dmBots/DM-H65-1EC/README.md

# DM-H65-1EC

[中文](./README.zh.md) | EN

## Overview

This folder is the Chinese source of materials for DM-H65-1EC. Maintainers update the Chinese source folders only; Gitee preserves them, and GitHub publishing maps them to English paths.

## Source Mapping

| Chinese source folder | GitHub publish folder | Notes |
| --- | --- | --- |
| `说明书/` | `manual/` | manuals, datasheets, and usage notes |
| `2D图纸/` | `drawings/2d/` | 2D drawings, dimensions, and schematic materials |
| `3D模型/` | `models/3d/` | 3D models and mechanical files |
| `测试数据/` | `test-data/` | test data, performance curves, and validation materials |
| `版本说明/` | `release-notes/` | release notes and change records |

## Publishing Policy

- The source folder keeps Chinese paths for maintainers.
- Gitee uses Chinese paths and Chinese README by default.
- GitHub is generated with English paths and English README by the publish script.
- Do not maintain a second English source tree manually.
