dmBots/DM-H65-1EC/测试数据/性能曲线/24V下速度效率.png

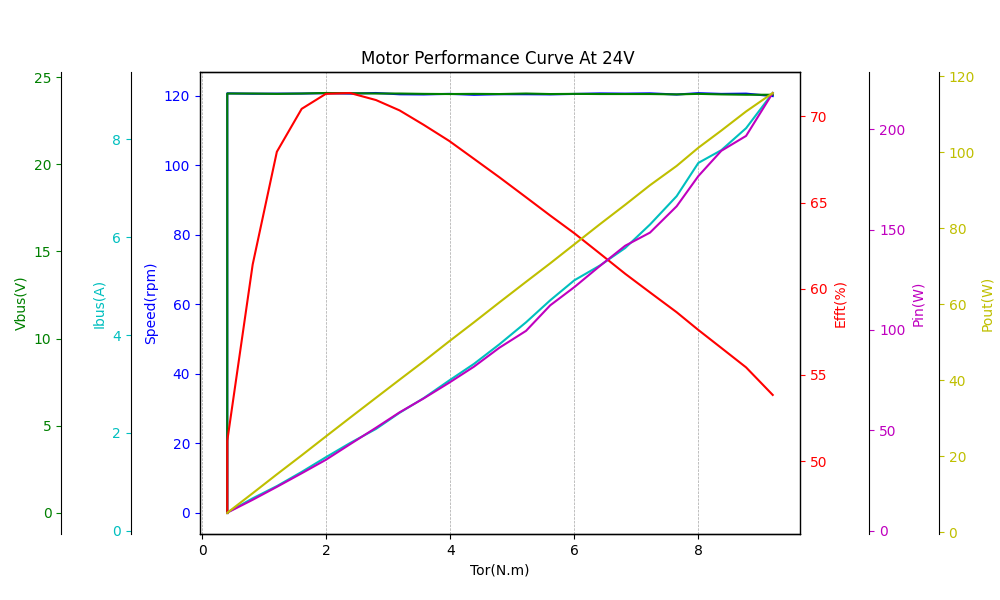
测试数据/性能曲线/24V下速度效率.png
