dmBots/DM-H65-1EC/测试数据/性能曲线/36V下扭矩效率.png

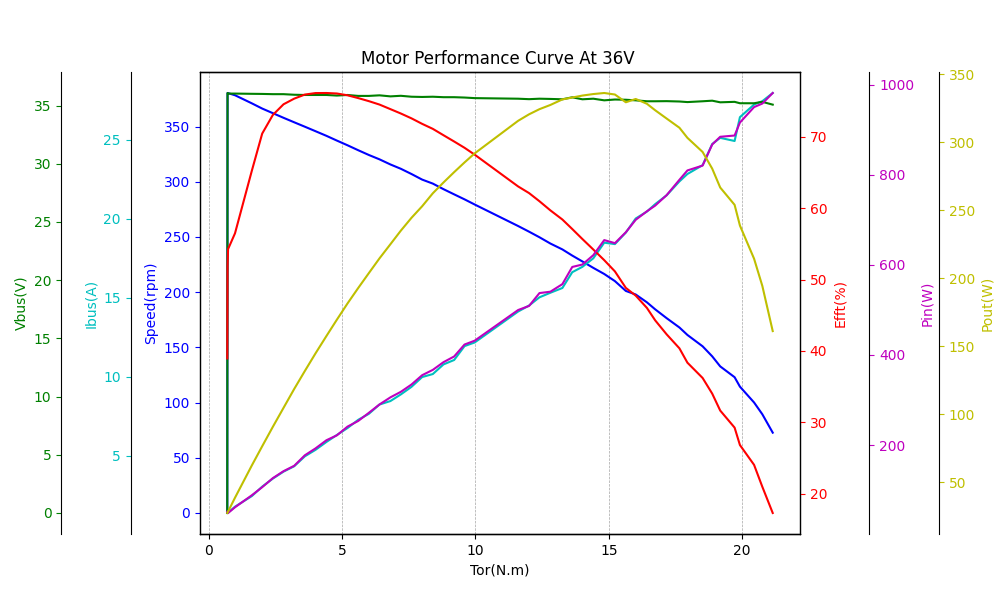
测试数据/性能曲线/36V下扭矩效率.png
