dmBots/DM-H65-1EC/测试数据/性能曲线/温升曲线.png

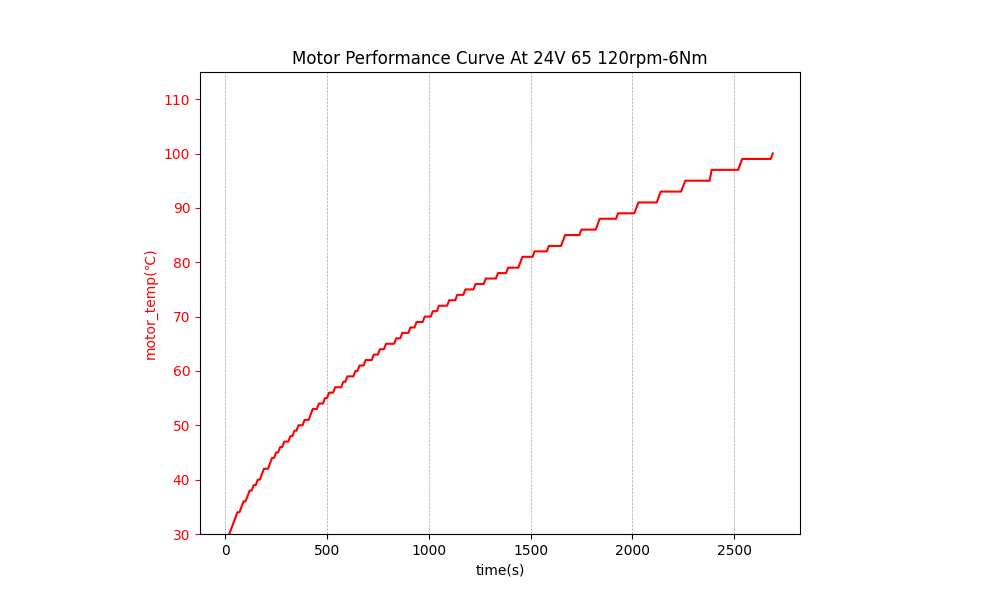
测试数据/性能曲线/温升曲线.png
