dmBots/DM-H65-1EC/测试数据/最大过载曲线/24v.png

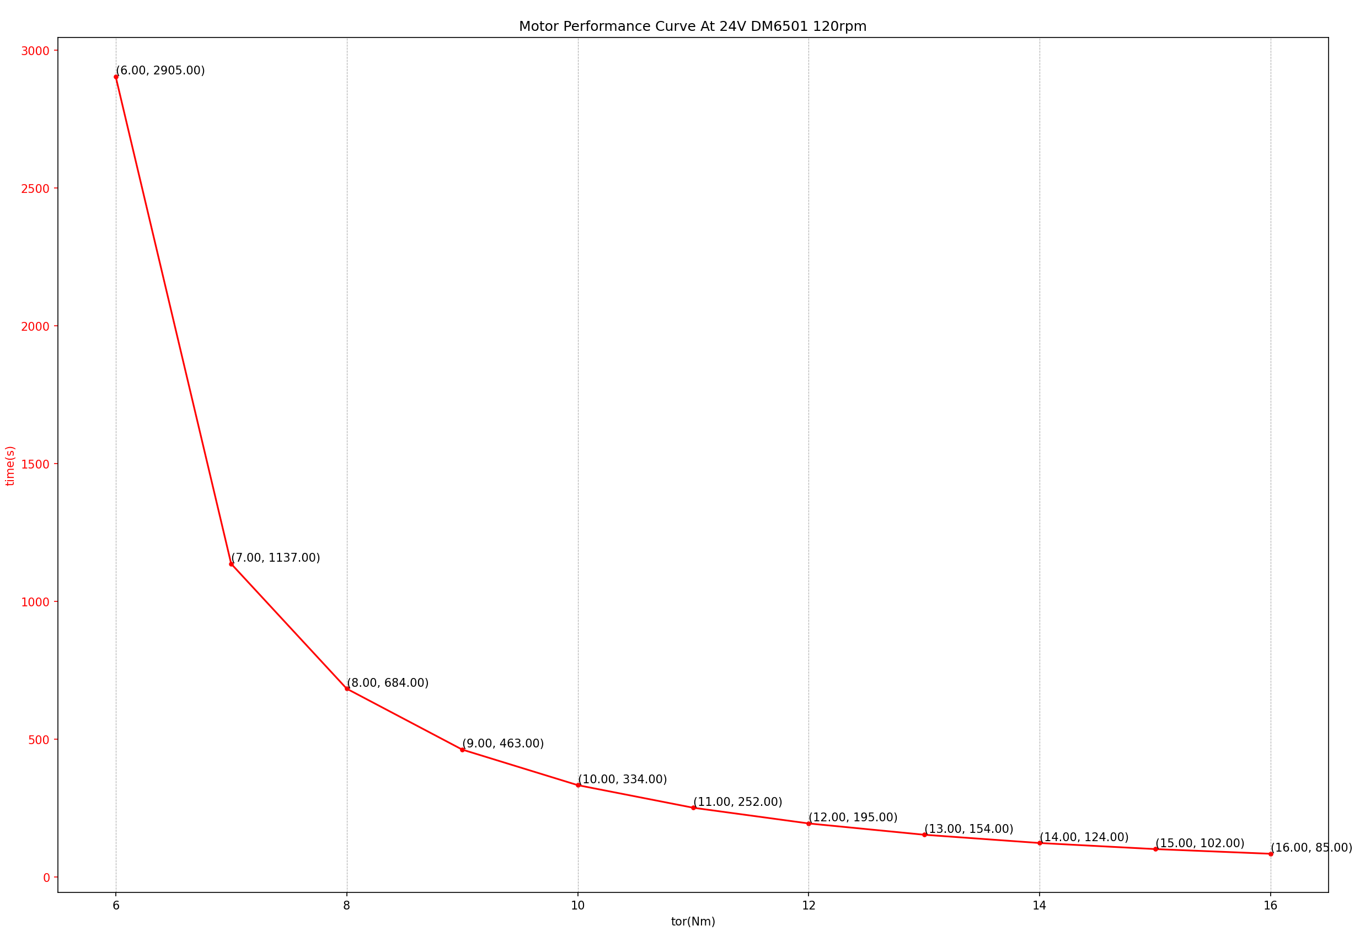
测试数据/最大过载曲线/24v.png
