dmBots/DM-H65-1EC/3D模型/6.5寸轮毂电机外形3D-达妙科技.STEP

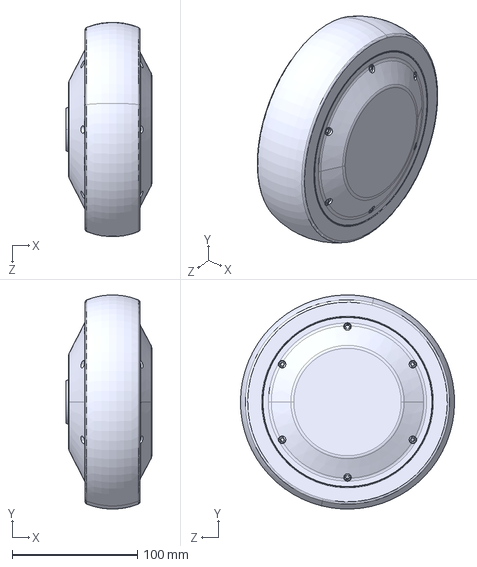
[picture p46: CAD file, 2025-12-01]
3D模型/6.5寸轮毂电机外形3D-达妙科技.STEP
68.3 x 170.7 x 170.8 mm
