dmBots/DM-H65-1EC/2D图纸/6.5寸轮毂电机-达妙科技.pdf

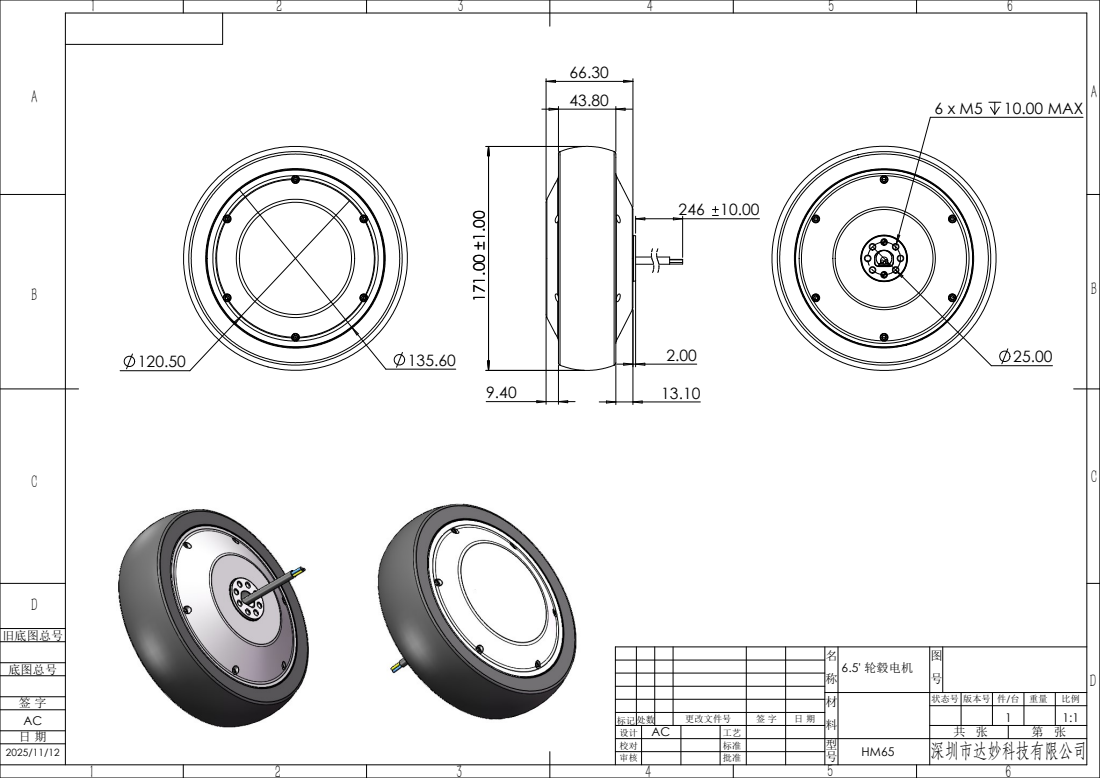
[picture p48: page 1]
标记处数; 更改文件号; 旧底图总号; 底图总号; 10.00 MAX; 9.40 ¹⁷¹.00 ±1.00

名 称 | 6.5' 轮毂电机 | 图 号

材 料 | | 状态号 | 版本号 | 件/台 | 重量 | 比例

设计 | AC | | 工艺 | | | | | 共 张 | 第 张
校对 | | | 标准 | | | 型 号 | HM65 | 深圳市达妙科技有限公司
审核 | | | 批准
