dmBots/DM-H65-1EC/(commit log)

2026-03-13 update 说明书/DM-H65 轮毂电机说明书V1.1 --2026.03.13.pdf
2026-05-19 docs: refresh H65 public materials
    [DM6540-1EC.STEP]
2026-06-29 docs: normalize public material structure
    [6.5寸轮毂电机外形3D-达妙科技.STEP, DM6540-1EC.STEP]
2026-06-30 chore: align public materials source
    [6.5寸轮毂电机外形3D-达妙科技.STEP, DM6540-1EC.STEP]
2026-07-02 chore: sync public materials from governed source
